chaostreff-flensburg/badge-schwammintelligenz/pcb/pcb.kicad_pcb

## KiCad design pcb/pcb.kicad_pcb (2026-08-19)

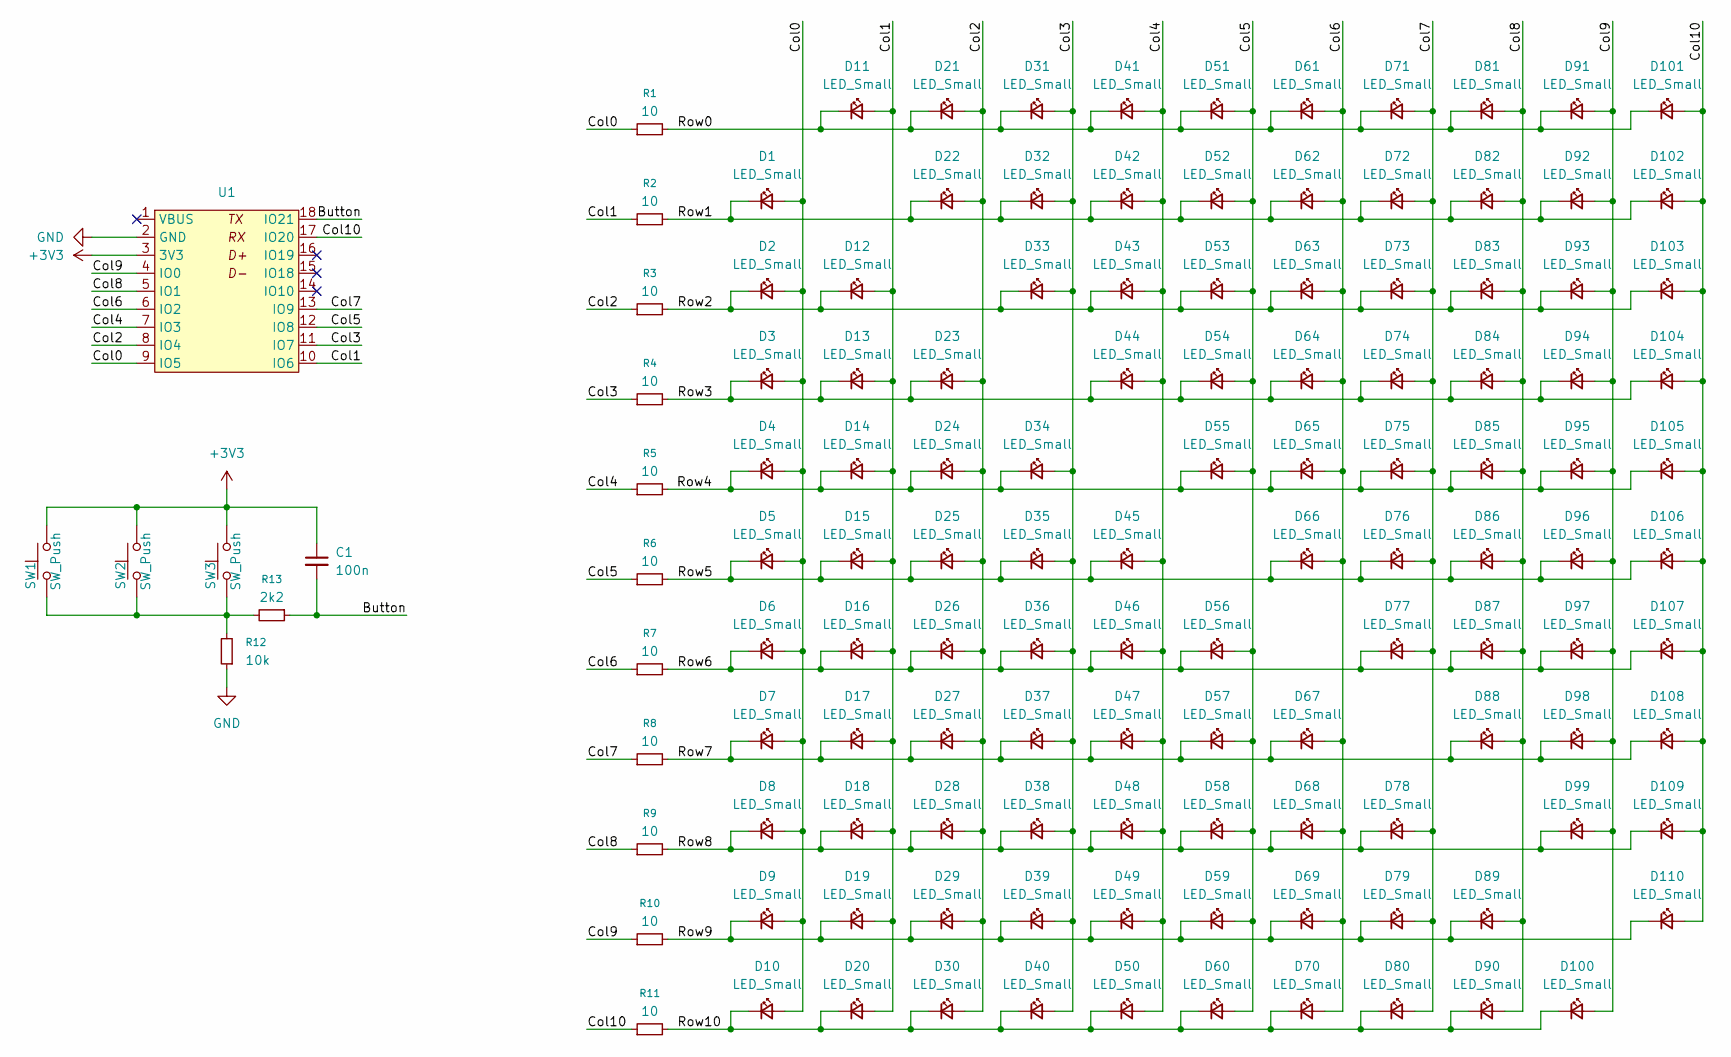
[picture p1: schematic pcb.kicad_sch]

Parts:
C1: 100n; C_0805_2012Metric_Pad1.18x1.45mm_HandSolder
D1, D2, D3, D4, D5, D6, D7, D8, D9, D10, D11, D12, D13, D14, D15, D16, D17, D18, D19, D20, D21, D22, D23, D24, D25, D26, D27, D28, D29, D30, D31, D32, D33, D34, D35, D36, D37, D38, D39, D40, D41, D42, D43, D44, D45, D46, D47, D48, D49, D50, D51, D52, D53, D54, D55, D56, D57, D58, D59, D60, D61, D62, D63, D64, D65, D66, D67, D68, D69, D70, D71, D72, D73, D74, D75, D76, D77, D78, D79, D80, D81, D82, D83, D84, D85, D86, D87, D88, D89, D90, D91, D92, D93, D94, D95, D96, D97, D98, D99, D100, D101, D102, D103, D104, D105, D106, D107, D108, D109, D110: LED_Small; XL-0201; LCSC C965789
R1, R2, R3, R4, R5, R6, R7, R8, R9, R10, R11: 10; R_0805_2012Metric_Pad1.20x1.40mm_HandSolder
R12: 10k; R_0805_2012Metric_Pad1.20x1.40mm_HandSolder
R13: 2k2; R_0805_2012Metric_Pad1.20x1.40mm_HandSolder
SW1, SW2, SW3: SW_Push; SW_Push_1P1T_NO_Alps_SPEH
U1: Waveshare-ESP32-Cx-Zero

Connections:
+3V3: C1.1, SW1.2, SW2.2, SW3.2, U1.3 (3V3)
/Button: C1.2, R13.1, U1.18 (IO21)
/Col0: D1.2 (A), D2.2 (A), D3.2 (A), D4.2 (A), D5.2 (A), D6.2 (A), D7.2 (A), D8.2 (A), D9.2 (A), D10.2 (A), R1.1, U1.9 (IO5)
/Col1: D11.2 (A), D12.2 (A), D13.2 (A), D14.2 (A), D15.2 (A), D16.2 (A), D17.2 (A), D18.2 (A), D19.2 (A), D20.2 (A), R2.1, U1.10 (IO6)
/Col2: D21.2 (A), D22.2 (A), D23.2 (A), D24.2 (A), D25.2 (A), D26.2 (A), D27.2 (A), D28.2 (A), D29.2 (A), D30.2 (A), R3.1, U1.8 (IO4)
/Col3: D31.2 (A), D32.2 (A), D33.2 (A), D34.2 (A), D35.2 (A), D36.2 (A), D37.2 (A), D38.2 (A), D39.2 (A), D40.2 (A), R4.1, U1.11 (IO7)
/Col4: D41.2 (A), D42.2 (A), D43.2 (A), D44.2 (A), D45.2 (A), D46.2 (A), D47.2 (A), D48.2 (A), D49.2 (A), D50.2 (A), R5.1, U1.7 (IO3)
/Col5: D51.2 (A), D52.2 (A), D53.2 (A), D54.2 (A), D55.2 (A), D56.2 (A), D57.2 (A), D58.2 (A), D59.2 (A), D60.2 (A), R6.1, U1.12 (IO8)
/Col6: D61.2 (A), D62.2 (A), D63.2 (A), D64.2 (A), D65.2 (A), D66.2 (A), D67.2 (A), D68.2 (A), D69.2 (A), D70.2 (A), R7.1, U1.6 (IO2)
/Col7: D71.2 (A), D72.2 (A), D73.2 (A), D74.2 (A), D75.2 (A), D76.2 (A), D77.2 (A), D78.2 (A), D79.2 (A), D80.2 (A), R8.1, U1.13 (IO9)
/Col8: D81.2 (A), D82.2 (A), D83.2 (A), D84.2 (A), D85.2 (A), D86.2 (A), D87.2 (A), D88.2 (A), D89.2 (A), D90.2 (A), R9.1, U1.5 (IO1)
/Col9: D91.2 (A), D92.2 (A), D93.2 (A), D94.2 (A), D95.2 (A), D96.2 (A), D97.2 (A), D98.2 (A), D99.2 (A), D100.2 (A), R10.1, U1.4 (IO0)
/Col10: D101.2 (A), D102.2 (A), D103.2 (A), D104.2 (A), D105.2 (A), D106.2 (A), D107.2 (A), D108.2 (A), D109.2 (A), D110.2 (A), R11.1, U1.17 (IO20)
/Row0: D11.1 (K), D21.1 (K), D31.1 (K), D41.1 (K), D51.1 (K), D61.1 (K), D71.1 (K), D81.1 (K), D91.1 (K), D101.1 (K), R1.2
/Row1: D1.1 (K), D22.1 (K), D32.1 (K), D42.1 (K), D52.1 (K), D62.1 (K), D72.1 (K), D82.1 (K), D92.1 (K), D102.1 (K), R2.2
/Row2: D2.1 (K), D12.1 (K), D33.1 (K), D43.1 (K), D53.1 (K), D63.1 (K), D73.1 (K), D83.1 (K), D93.1 (K), D103.1 (K), R3.2
/Row3: D3.1 (K), D13.1 (K), D23.1 (K), D44.1 (K), D54.1 (K), D64.1 (K), D74.1 (K), D84.1 (K), D94.1 (K), D104.1 (K), R4.2
/Row4: D4.1 (K), D14.1 (K), D24.1 (K), D34.1 (K), D55.1 (K), D65.1 (K), D75.1 (K), D85.1 (K), D95.1 (K), D105.1 (K), R5.2
/Row5: D5.1 (K), D15.1 (K), D25.1 (K), D35.1 (K), D45.1 (K), D66.1 (K), D76.1 (K), D86.1 (K), D96.1 (K), D106.1 (K), R6.2
/Row6: D6.1 (K), D16.1 (K), D26.1 (K), D36.1 (K), D46.1 (K), D56.1 (K), D77.1 (K), D87.1 (K), D97.1 (K), D107.1 (K), R7.2
/Row7: D7.1 (K), D17.1 (K), D27.1 (K), D37.1 (K), D47.1 (K), D57.1 (K), D67.1 (K), D88.1 (K), D98.1 (K), D108.1 (K), R8.2
/Row8: D8.1 (K), D18.1 (K), D28.1 (K), D38.1 (K), D48.1 (K), D58.1 (K), D68.1 (K), D78.1 (K), D99.1 (K), D109.1 (K), R9.2
/Row9: D9.1 (K), D19.1 (K), D29.1 (K), D39.1 (K), D49.1 (K), D59.1 (K), D69.1 (K), D79.1 (K), D89.1 (K), D110.1 (K), R10.2
/Row10: D10.1 (K), D20.1 (K), D30.1 (K), D40.1 (K), D50.1 (K), D60.1 (K), D70.1 (K), D80.1 (K), D90.1 (K), D100.1 (K), R11.2
GND: R12.1, U1.2 (GND)
unnamed: R12.2, R13.2, SW1.1, SW2.1, SW3.1

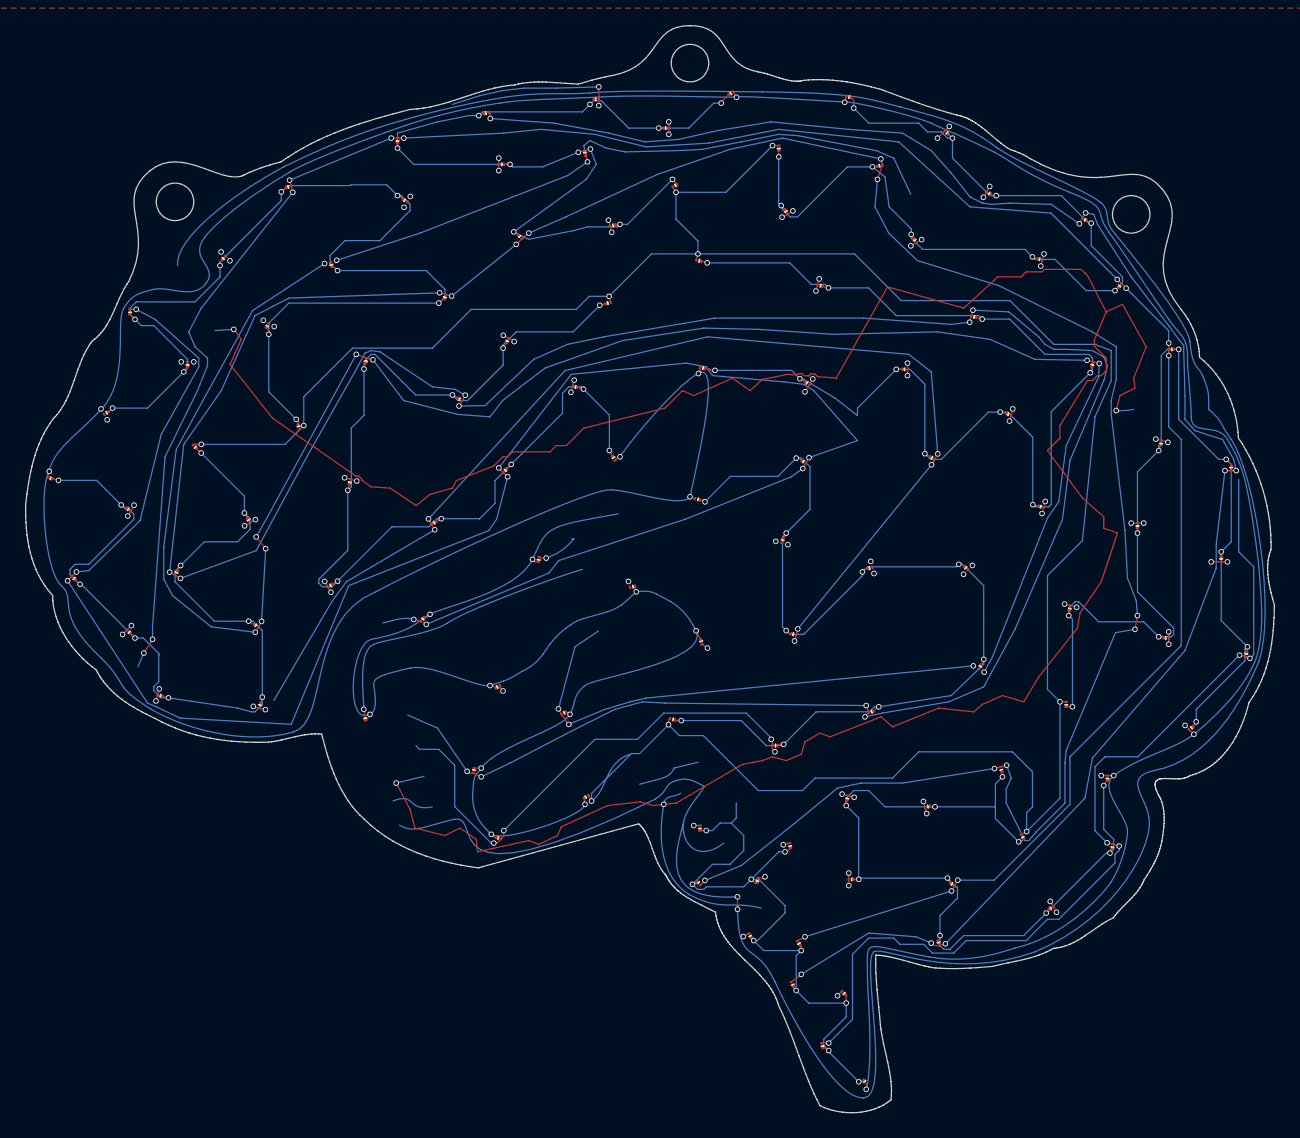
[picture p2: board pcb.kicad_pcb from above]

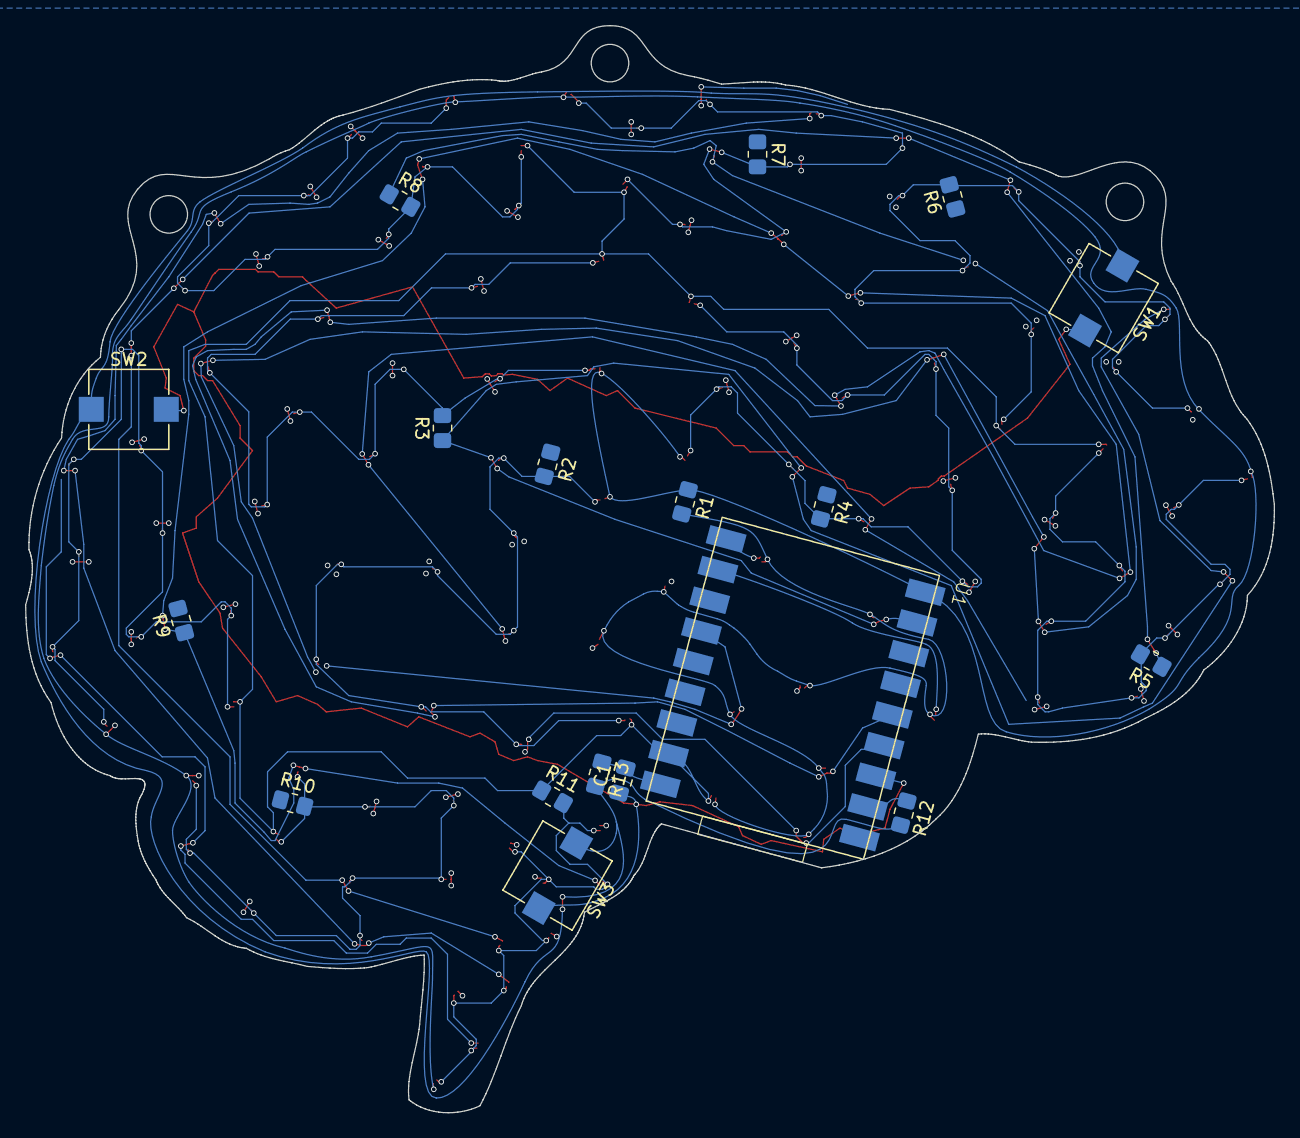
[picture p3: board pcb.kicad_pcb from below]

Board: 2 copper layers, 99.9 x 87.0 mm, 128 parts (18 on the bottom side), 26 nets.
